Luup2177/MotusGlove-esp32/docs/imagens/circuito-motusglove-alta-resolucao.png

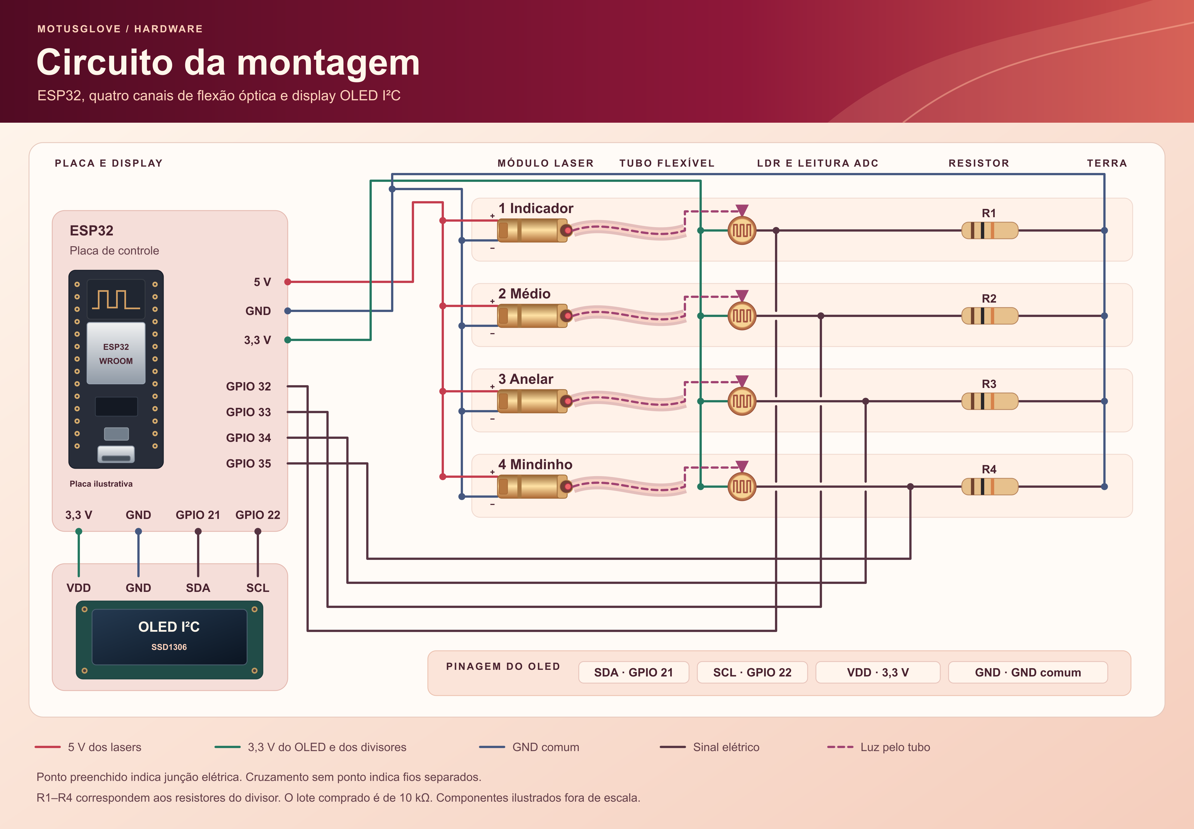
docs/imagens/circuito-motusglove-alta-resolucao.png
