Luup2177/MotusGlove-esp32/docs/Painéis de Marca Motus Glove em Tons Quentes.png

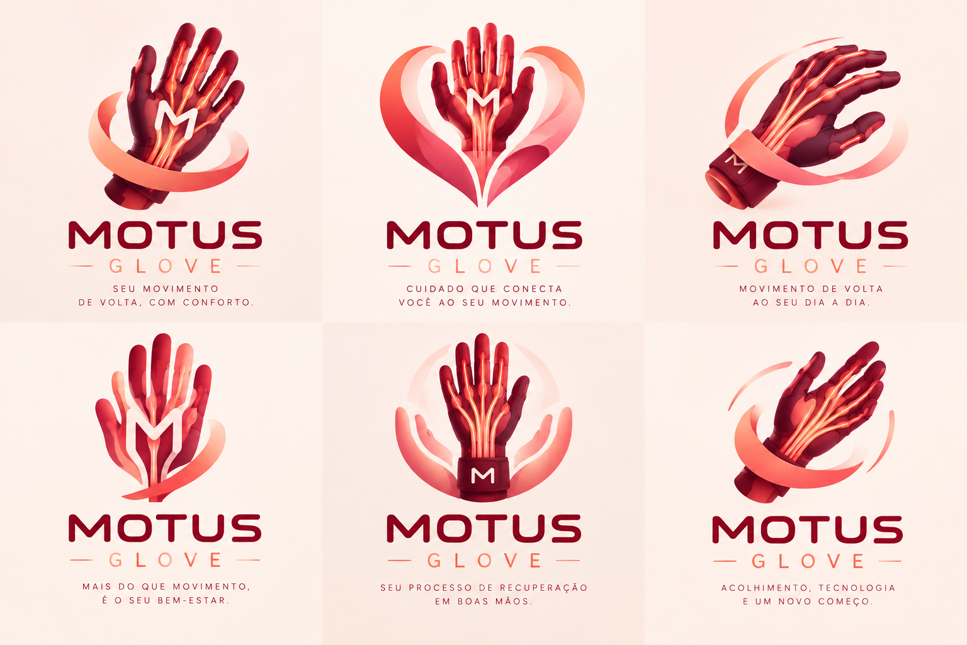
docs/Painéis de Marca Motus Glove em Tons Quentes.png
