Luup2177/MotusGlove-esp32/3D/Caixa_MotusGlove.stl

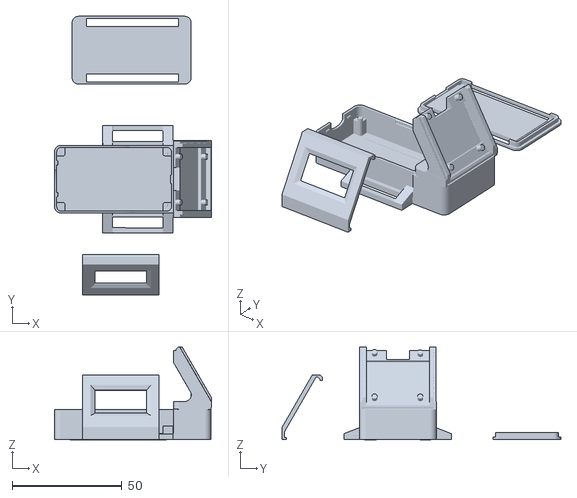
[picture p5: CAD file, 2026-11-10]
3D/Caixa_MotusGlove.stl
71.7 x 127.2 x 42.3
