Luup2177/MotusGlove-esp32/3D/Suporte_MotusGlove.stl

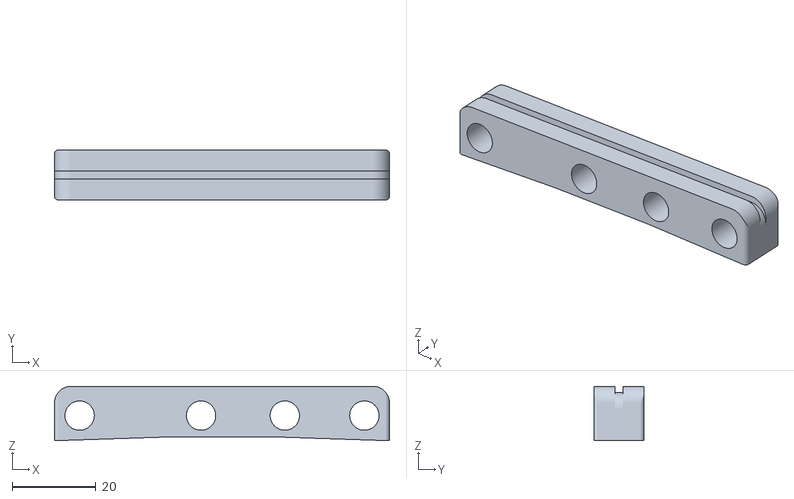
[picture p6: CAD file, 2026-11-10]
3D/Suporte_MotusGlove.stl
80.0 x 12.0 x 13.0
